shadysx/simrig/hardware.md

# Hardware

## Bass Shakers

- 2x Dayton Audio BST-1 Bass Shaker (50w) / BST-1
- Nobsound NS-01G PRO Stereo Amplifier / NS-01G PRO

## Sim Cockpit

- OPLITE GTR S8 Infinity
