shadysx/simrig/hand-brake/sim-racing-handbrake-load-cell-model_files/1532021-sim-racing-handbrake-load-cell-37267cfc-fd38-4c65-a605-1fc97a40fd0b.pdf

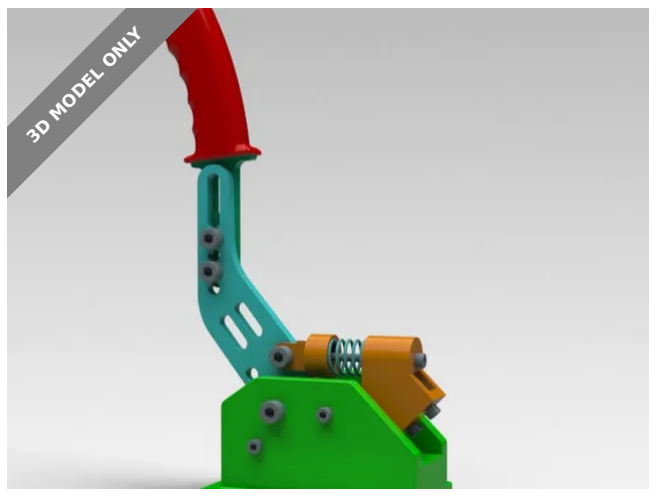
[picture p1: figure]
3D MODEL ONLY

## Summary

Sim racing handbrake with load cell.

Gadgets (https://printables.com/model?categoryId=21) > Computers (https://printables.com/model?categoryId=27)

Tags: | simracing | handbrake | assettocorsa | laodcell

This project is a remix of the mentioned potentiometer-based sim racing handbrake, upgraded to use a load cell for force-based measurement instead of position-based input.

The result is a much more realistic handbrake feel, similar to real hydraulic handbrakes used in motorsport.

Compatible with Arduino Uno using UnoJoy
Adjustable stiffness depending on spring and preload
Uses mostly 3D-printed parts

Hardware used:

Load cell (typically 10–50 kg ( https://www.sparkfun.com/load-cell-10kg-straight-bar-tal220.html#content-features)) (https://www.sparkfun.com/load-cell-10kg-straight-bar-tal220.html#content-features)
HX711 load cell amplifier
Springs (user preference)
2xM4x18 bolts

eruiec (https://printables.com/@eruiec11_3068412)

## Sim Racing Handbrake – Load Cell

VIEW IN BROWSER (https://printables.com/model/1532021-sim-racing-handbrake-load-cell)

updated 28. 12. 2025 | published 28. 12. 2025

•
•
•

•

•
•
•

## Model files

6xM5x18 bolts + 4xM5 nut
3xM5x70 bolts + 3xM5 nut
3xM8x30 bolts + 3xM8 nut
M8x70 bolt + M8 nut
Arduino with USB cable

Firmware:

Arduino Uno flashed with UnoJoy (see unojoy instructions: https://github.com/AlanChatham/UnoJoy)

Calibration:

Windows Game Controller settings In-game control settings
Tested with Assetto Corsa

Disclaimer:

This is a DIY project. Assembly and use are at your own risk. Ensure proper wiring and secure mounting before use.

## This remix is based on

Sim Racing Handbrake V2 (https://printables.com/model/550159-sim-racing-handbrake-v2)
by Thornyx (https://printables.com/@Thornyx)

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
2025-11-30-spacer.stl

2025-12-28-upper-handle.stl

2025-12-28-spacer-2.stl

2025-11-30-slider-joint.stl

2025-11-30-joint-spring.stl

2025-11-30-clamp.stl

2025-11-25-clamp-screw.stl

2025-12-28-lower-handle.stl

2025-12-11-handle.stl

2025-12-11-handle-2.stl

2025-12-28-base.stl

## Other files

- Arduino and unojoy code

## License

This work is licensed under a
Creative Commons (4.0 International License)

Attribution-NonCommercial (http://creativecommons.org/licenses/by-nc/4.0/)

✖ | Sharing without ATTRIBUTION
✔ | Remix Culture allowed
✖ | Commercial Use
✖ | Free Cultural Works
✖ | Meets Open Definition

2025-12-28-handbrake-loadcell.ino
