shadysx/simrig/hand-brake/sim-racing-handbrake-load-cell-model_files/slider_joint.step

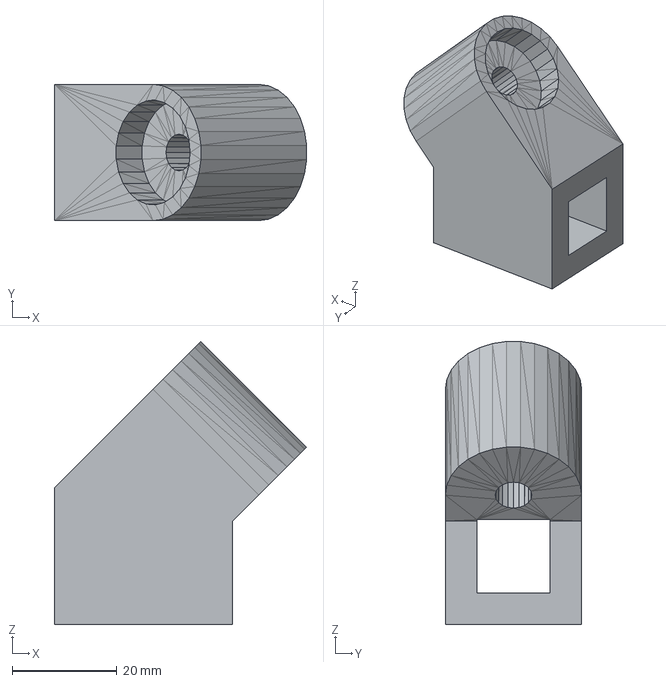
[picture p2: CAD file, 2026-09-16]
hand-brake/sim-racing-handbrake-load-cell-model_files/slider_joint.step
48.1 x 26.0 x 54.0 mm
