shadysx/simrig/hand-brake/sim-racing-handbrake-load-cell-model_files/2025-12-28-spacer-2.stl

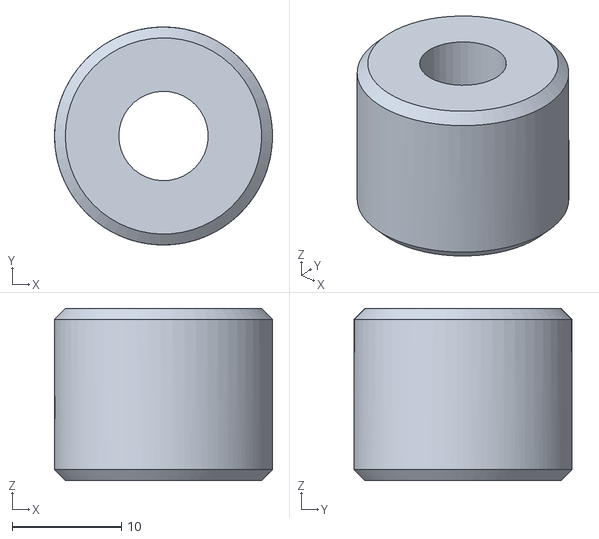
[picture p3: CAD file, 2026-09-16]
hand-brake/sim-racing-handbrake-load-cell-model_files/2025-12-28-spacer-2.stl
20.0 x 20.0 x 15.8
