shadysx/simrig/hand-brake/sim-racing-handbrake-load-cell-model_files/2025-12-11-handle.stl

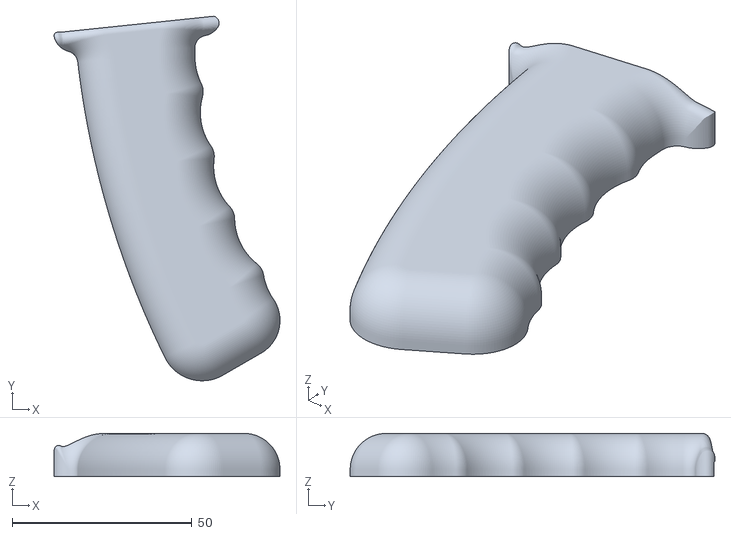
[picture p4: CAD file, 2026-09-16]
hand-brake/sim-racing-handbrake-load-cell-model_files/2025-12-11-handle.stl
62.8 x 101.3 x 12.0
