shadysx/simrig/hand-brake/sim-racing-handbrake-load-cell-model_files/2025-11-30-spacer.stl

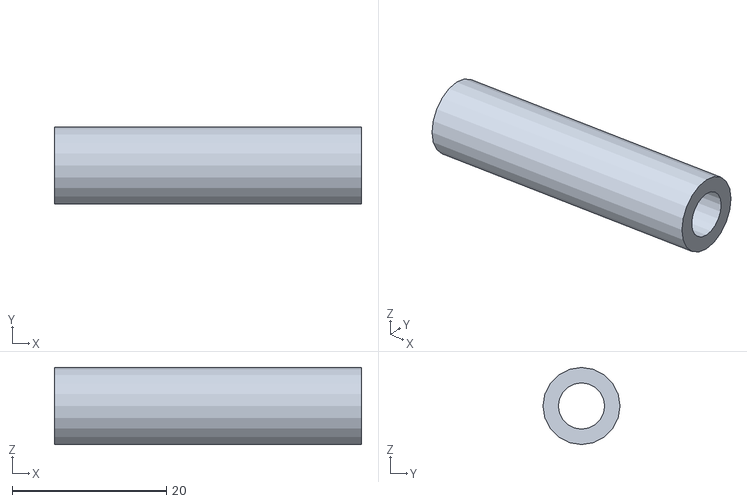
[picture p5: CAD file, 2026-09-16]
hand-brake/sim-racing-handbrake-load-cell-model_files/2025-11-30-spacer.stl
39.8 x 10.0 x 10.0
