shadysx/simrig/hand-brake/sim-racing-handbrake-load-cell-model_files/2025-12-28-upper-handle.stl

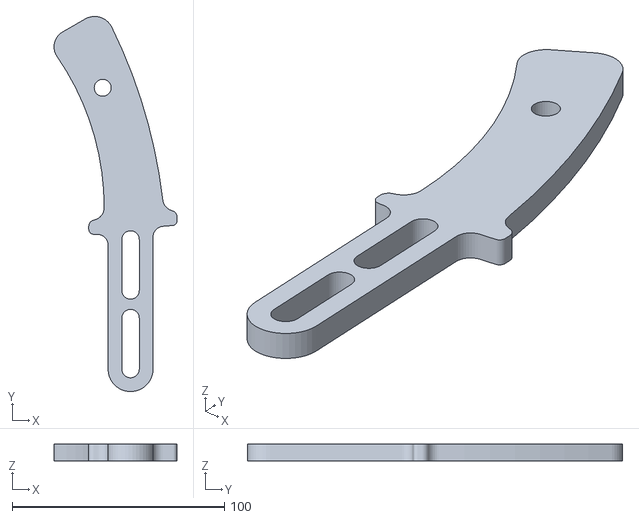
[picture p6: CAD file, 2026-09-16]
hand-brake/sim-racing-handbrake-load-cell-model_files/2025-12-28-upper-handle.stl
57.9 x 176.5 x 7.90
