shadysx/simrig/hand-brake/sim-racing-handbrake-load-cell-model_files/2025-12-28-base.stl

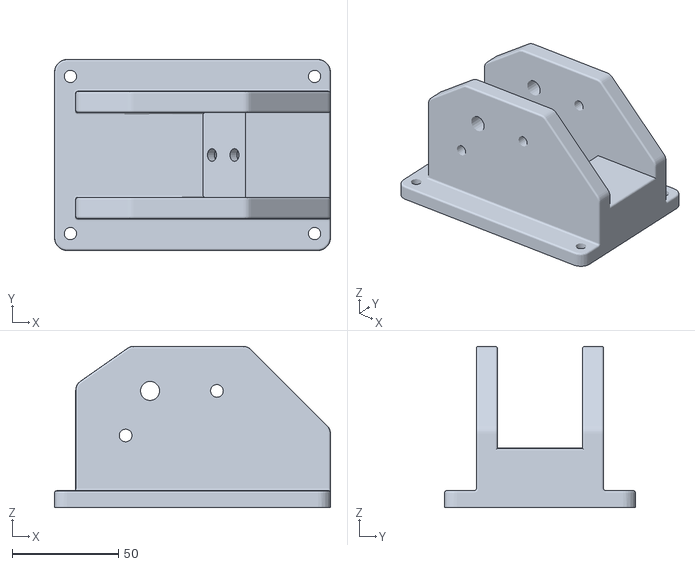
[picture p7: CAD file, 2026-09-16]
hand-brake/sim-racing-handbrake-load-cell-model_files/2025-12-28-base.stl
130.0 x 90.0 x 76.0
