shadysx/simrig/hand-brake/sim-racing-handbrake-load-cell-model_files/2025-11-30-clamp.stl

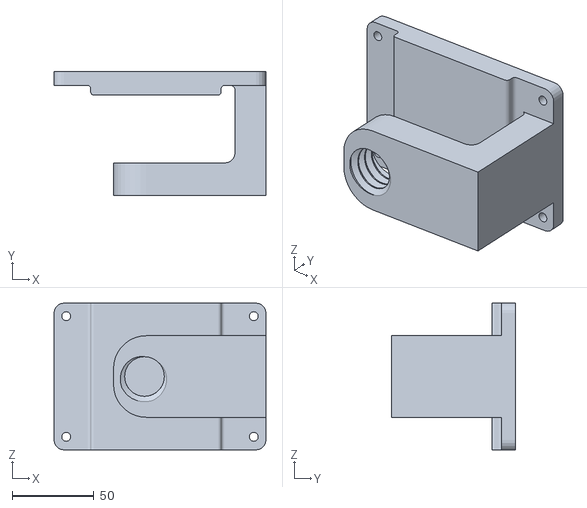
[picture p8: CAD file, 2026-09-16]
hand-brake/sim-racing-handbrake-load-cell-model_files/2025-11-30-clamp.stl
130.0 x 76.0 x 90.0
