shadysx/simrig/hand-brake/sim-racing-handbrake-load-cell-model_files/slider sprint 23mm.step

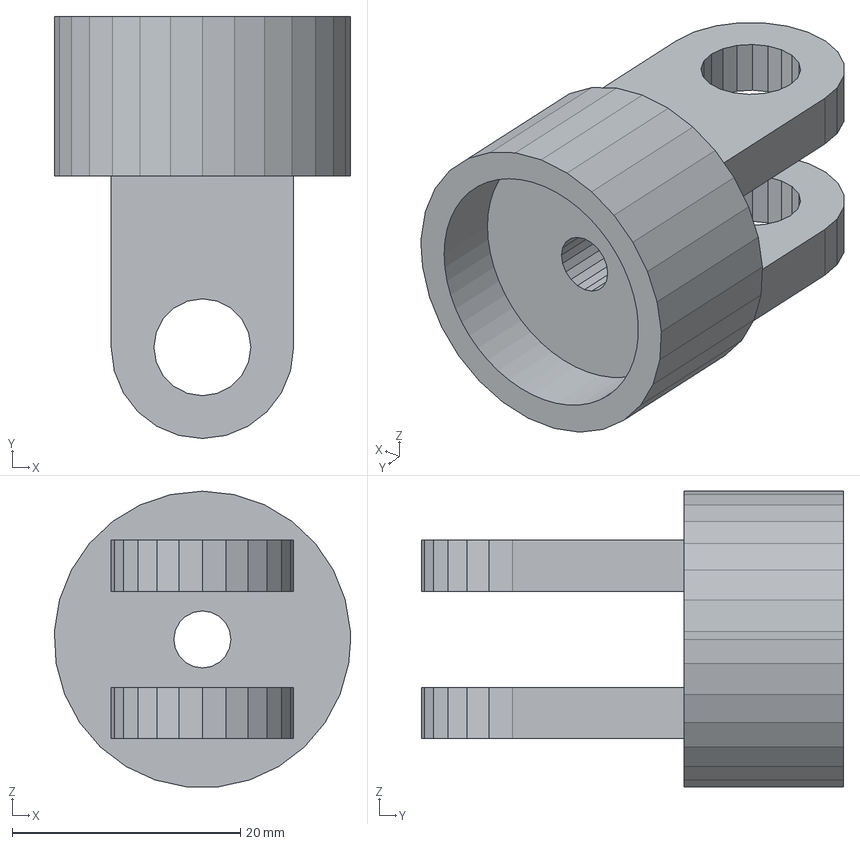
[picture p9: CAD file, 2026-09-16]
hand-brake/sim-racing-handbrake-load-cell-model_files/slider sprint 23mm.step
26.0 x 37.0 x 25.9 mm
