shadysx/simrig/hand-brake/sim-racing-handbrake-load-cell-model_files/2025-12-28-lower-handle.stl

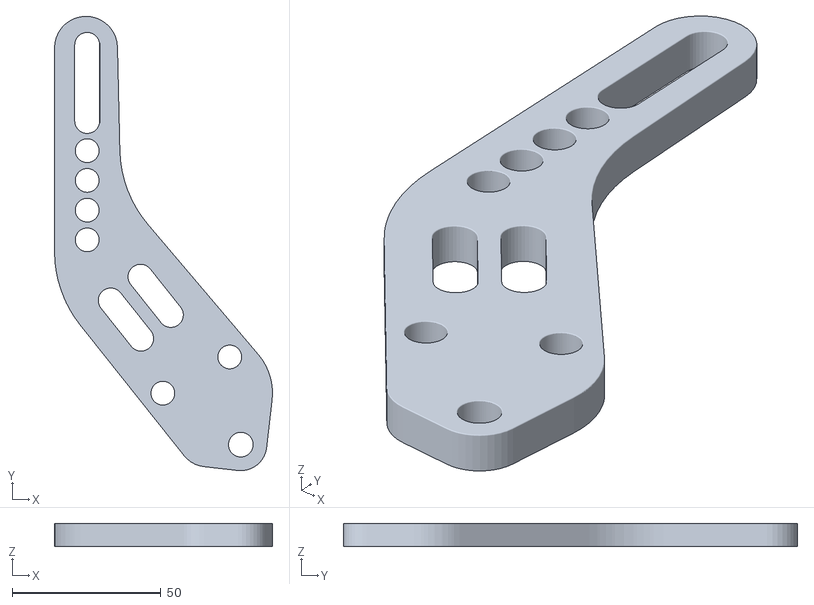
[picture p10: CAD file, 2026-09-16]
hand-brake/sim-racing-handbrake-load-cell-model_files/2025-12-28-lower-handle.stl
73.3 x 152.8 x 7.80
