shadysx/simrig/hand-brake/sim-racing-handbrake-load-cell-model_files/Joint Slider v1.step

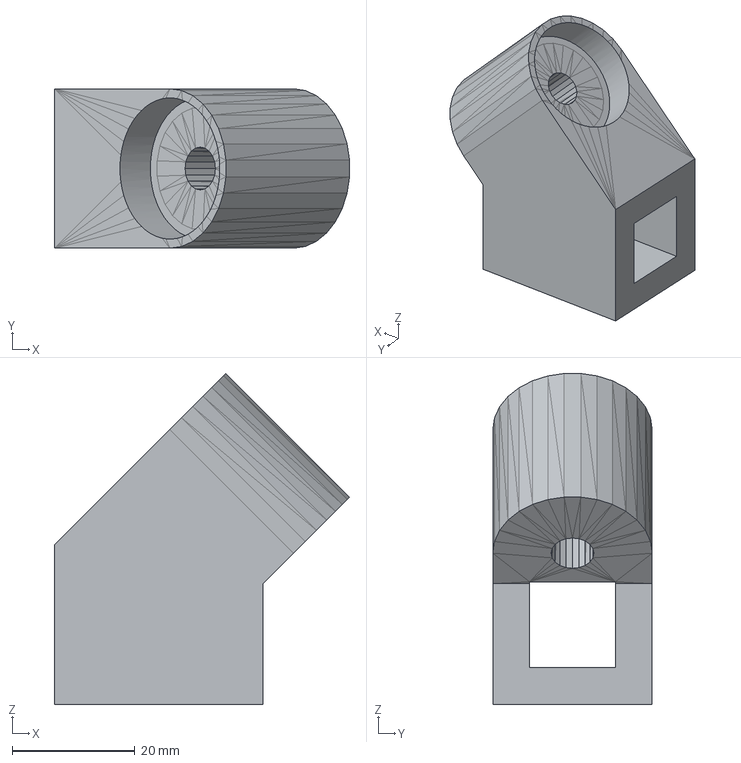
[picture p11: CAD file, 2026-09-16]
hand-brake/sim-racing-handbrake-load-cell-model_files/Joint Slider v1.step
48.1 x 26.0 x 54.0 mm
