shadysx/simrig/hand-brake/sim-racing-handbrake-load-cell-model_files/2025-11-25-clamp-screw.stl

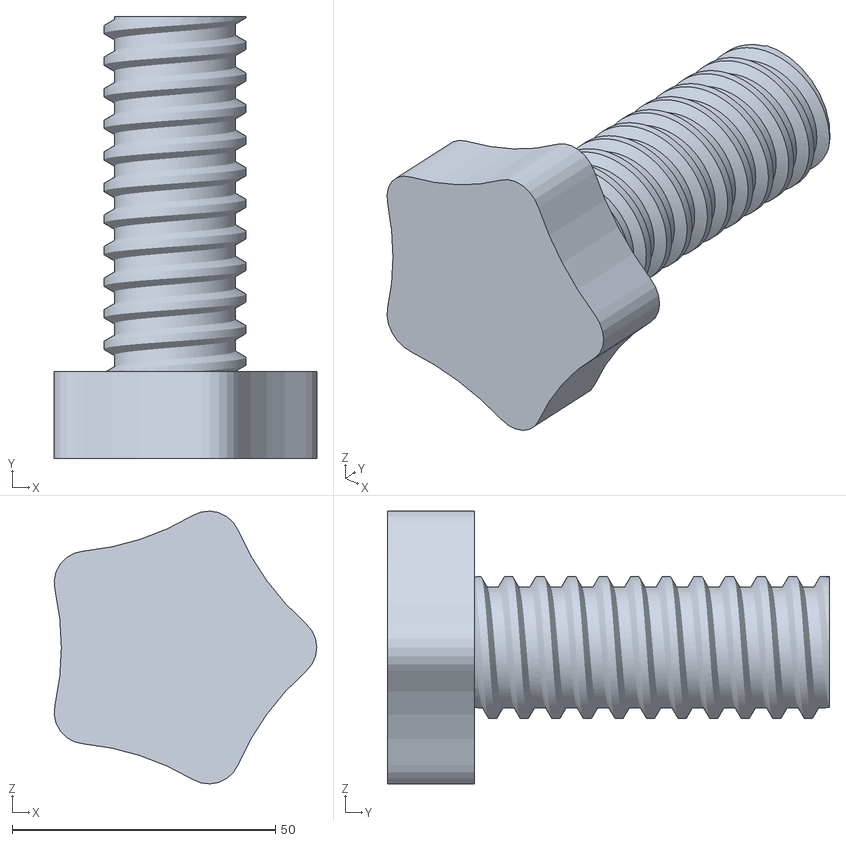
[picture p12: CAD file, 2026-09-16]
hand-brake/sim-racing-handbrake-load-cell-model_files/2025-11-25-clamp-screw.stl
49.9 x 84.0 x 51.9
