shadysx/simrig/(list of files, cad)

Other CAD files:
hand-brake/sim-racing-handbrake-load-cell-model_files/2025-12-11-handle-2.stl
hand-brake/sim-racing-handbrake-load-cell-model_files/2025-11-30-slider-joint.stl
hand-brake/sim-racing-handbrake-load-cell-model_files/2025-11-30-joint-spring.stl
hand-brake/sim-racing-handbrake-load-cell-model_files/Unnamed-_2025_11_30_joint_spring001 (Solid)001.step
hand-brake/sim-racing-handbrake-load-cell-model_files/SliderSprint-23mm.f3d
